patrickjamesmardis/longDistanceLamp/documentationAssets/finalObject_schem.jpg

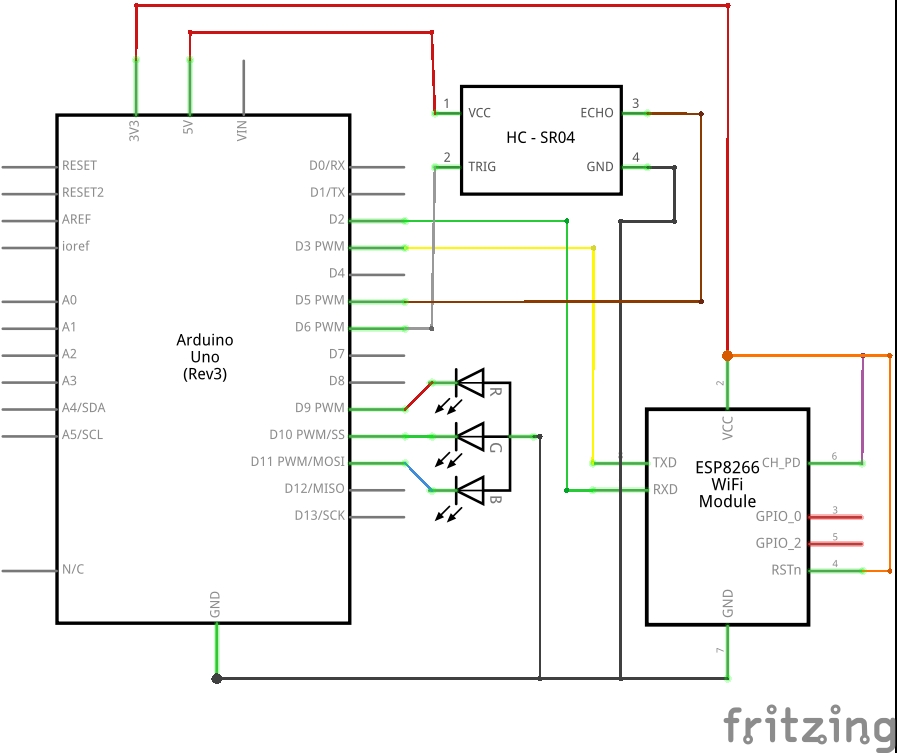
documentationAssets/finalObject_schem.jpg
