patrickjamesmardis/longDistanceLamp/final-esp/data/lampBase.obj

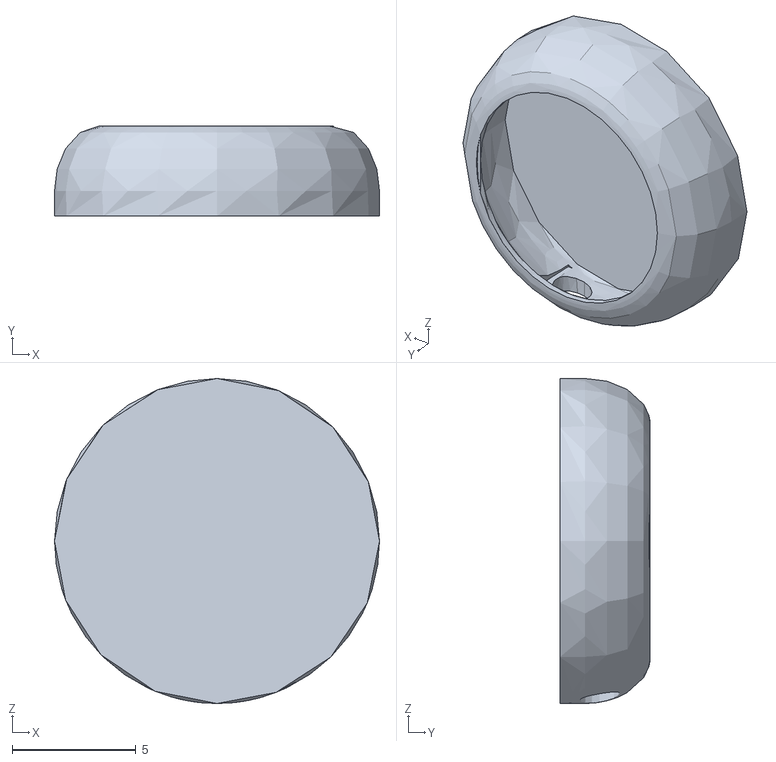
[picture p16: CAD file, 2020-12-09]
final-esp/data/lampBase.obj
13.1 x 3.66 x 13.1
